fortcollinscreatorhub/founders-plaques/plaques/hidden-rectangle.png

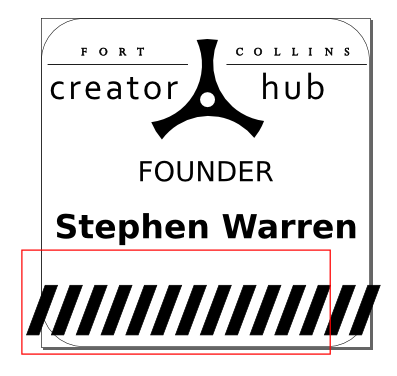
plaques/hidden-rectangle.png
