fortcollinscreatorhub/founders-plaques/(commit log)

2015-09-24 Add vector image files used to etch/cut the plaques
    Also add a bitmap image pointing out the location of the extra hidden
    rectangle that exists in the EMF files. This needs to be deleted manually
    after importing into the LASER software. This object has now been removed
    from the master SVG file, so any future exports shouldn't have this
    issue.
2023-10-28 Add slate replacement files
    The PSU for the LED sign has failed, and we don't run the LEDs much since
    it triggers the motion-sensitive cameras. The plastic plaques are
    difficult to read without the LEDs. So, I'm working on replacing the
    plastic plaques with LASER-engraved slate tiles instead. These are the
    design files for that.
